MaShaoDe/RiserBoards-FT101/docs/images/README.md

# Photos

Photos for [assembly.md](../assembly.md). Licensed CC-BY-4.0. JPEG, about 1600 px wide is plenty.

| File | Shows |
|---|---|
| `01-boards-delivered.jpg` | Bare boards as delivered, top and bottom side |
| `02-connector-fitted.jpg` | Connector pushed onto the edge, side view, pins on the pads |
| `03-soldered.jpg` | Finished solder joints |
| `04-in-use.jpg` | Riser with a card in an FT-101 or FT-277 |
| `title.png` | Title image of the README (rendered from the RB18 Gerber files) |

Until the photos are added, the links in assembly.md show as missing images.
