MaShaoDe/RiserBoards-FT101/hardware/riser-2x10/preview.png

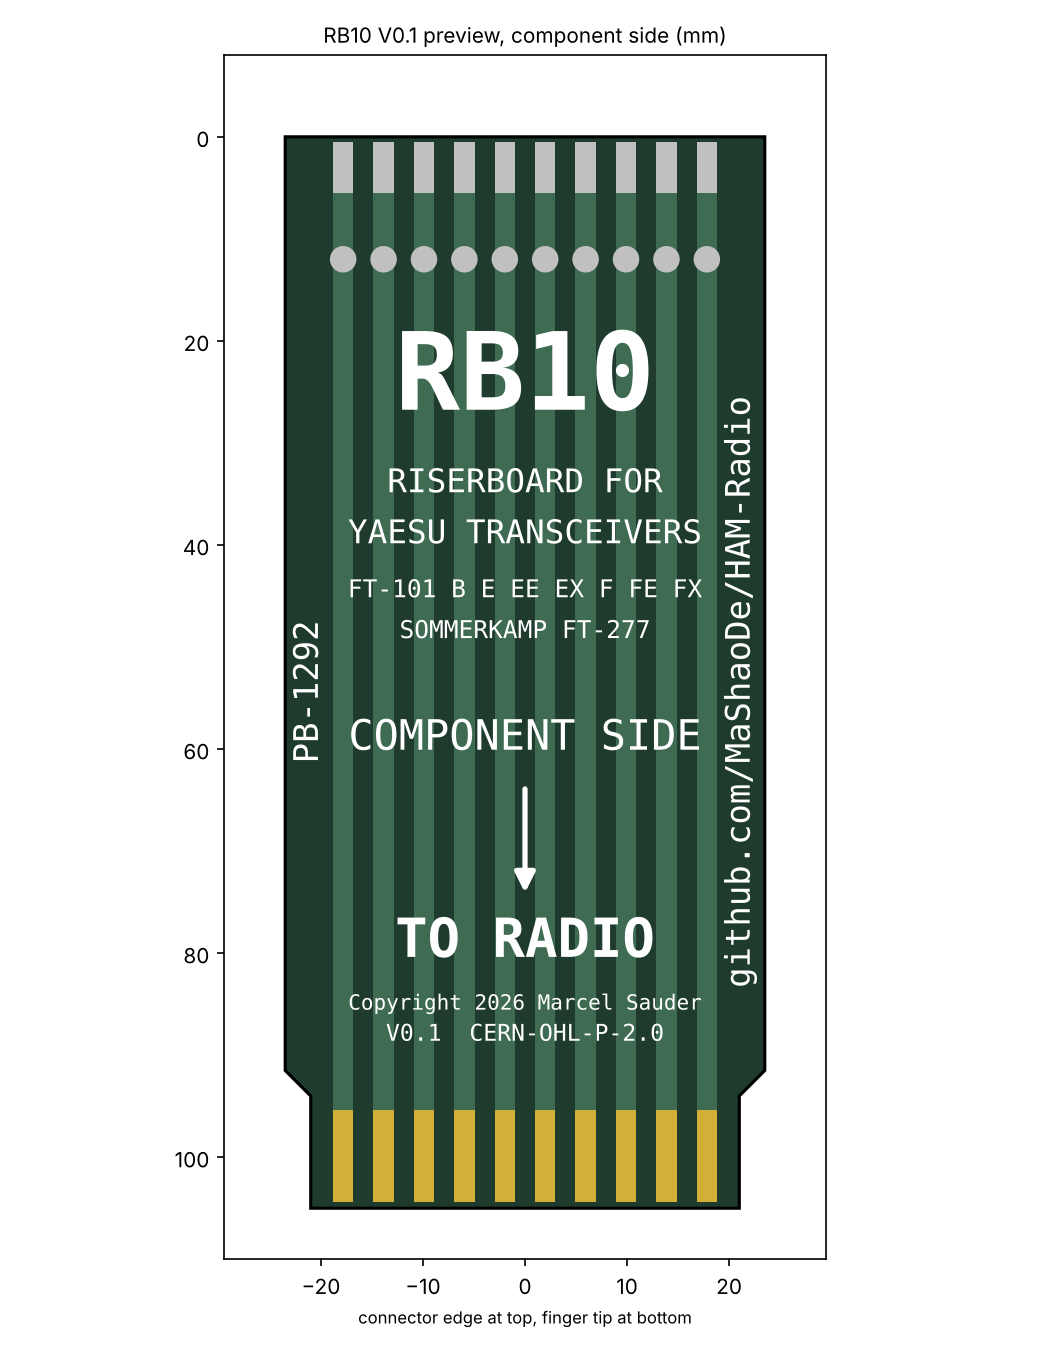
hardware/riser-2x10/preview.png
