MaShaoDe/RiserBoards-FT101/hardware/riser-2x14/preview.png

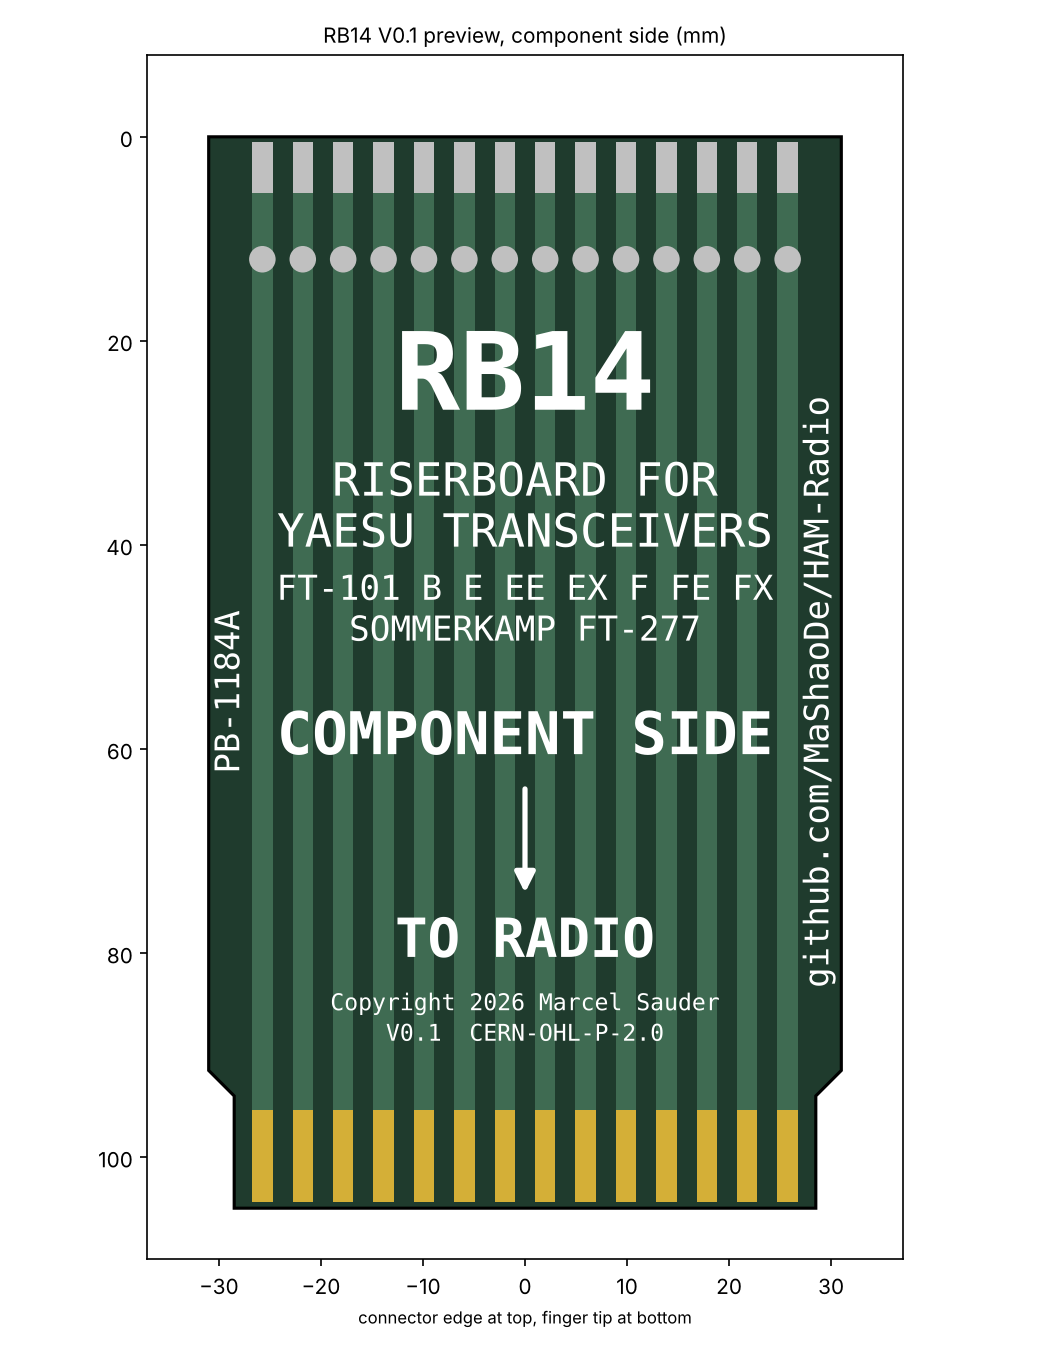
hardware/riser-2x14/preview.png
