MaShaoDe/RiserBoards-FT101/hardware/riser-2x18/preview.png

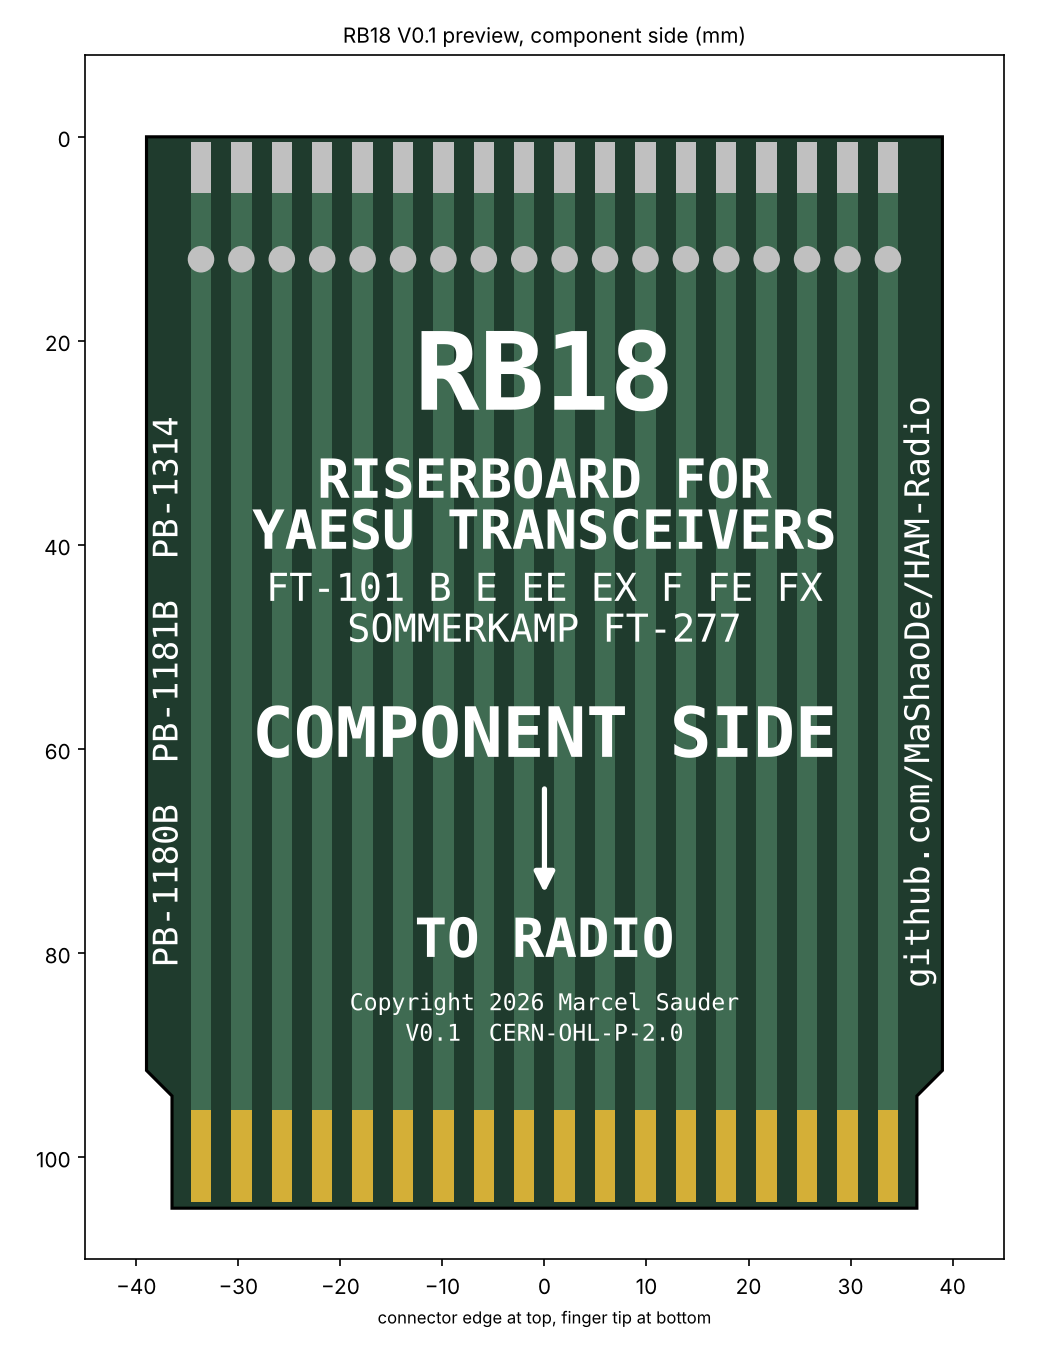
hardware/riser-2x18/preview.png
