MaShaoDe/RiserBoards-FT101/hardware/riser-2x22/preview.png

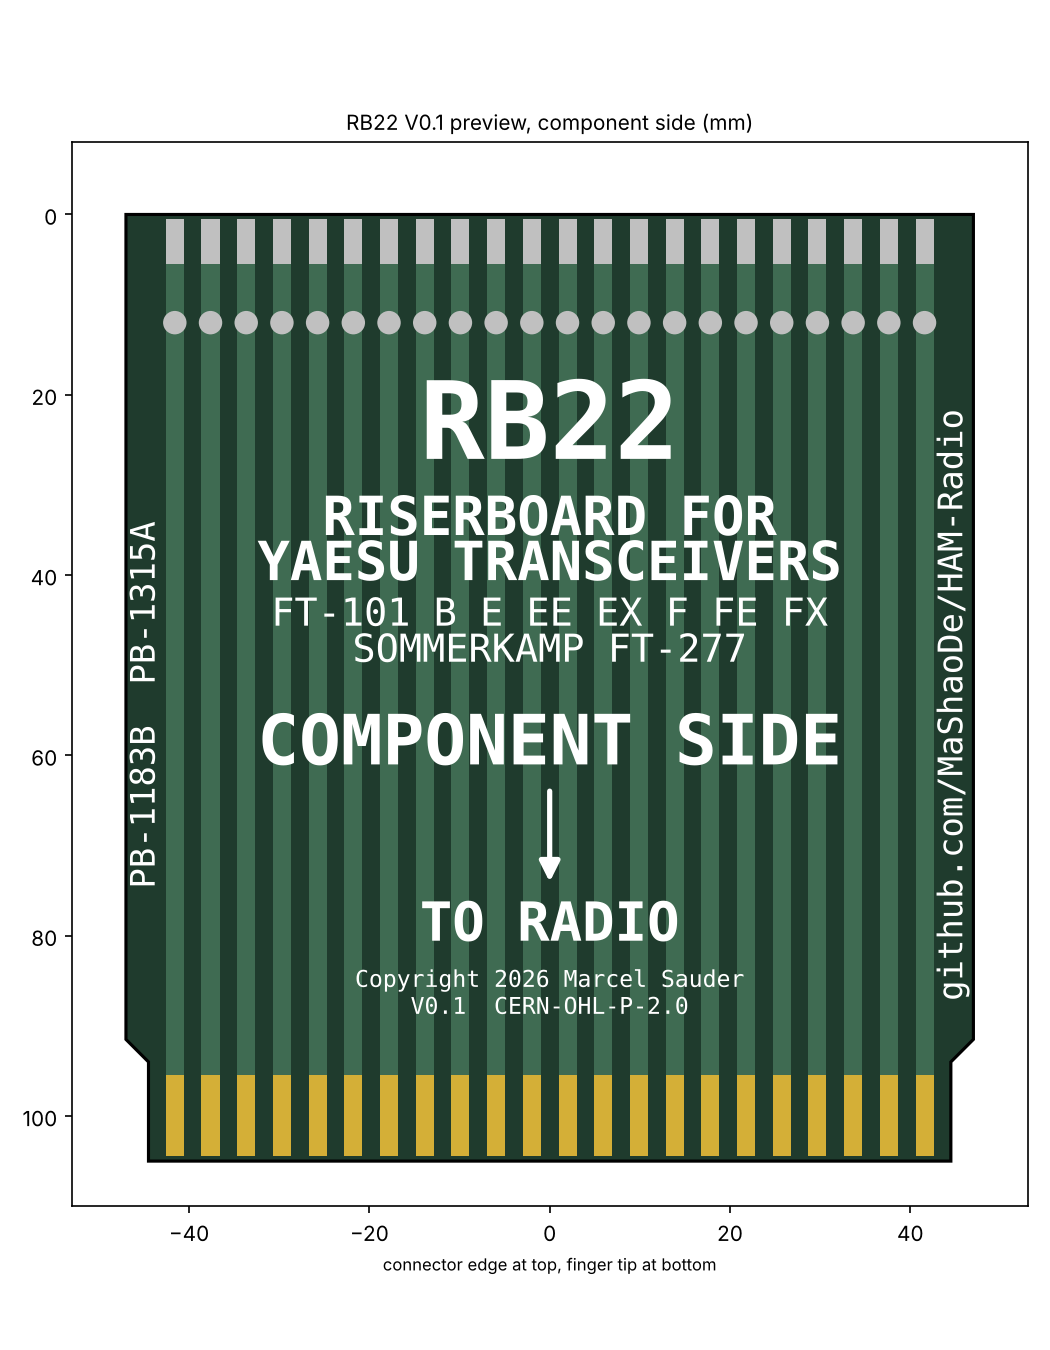
hardware/riser-2x22/preview.png
