MaShaoDe/RiserBoards-FT101/hardware/riser-2x14/riser-2x14.kicad_pcb

## KiCad design hardware/riser-2x14/riser-2x14.kicad_pcb (2026-11-12)

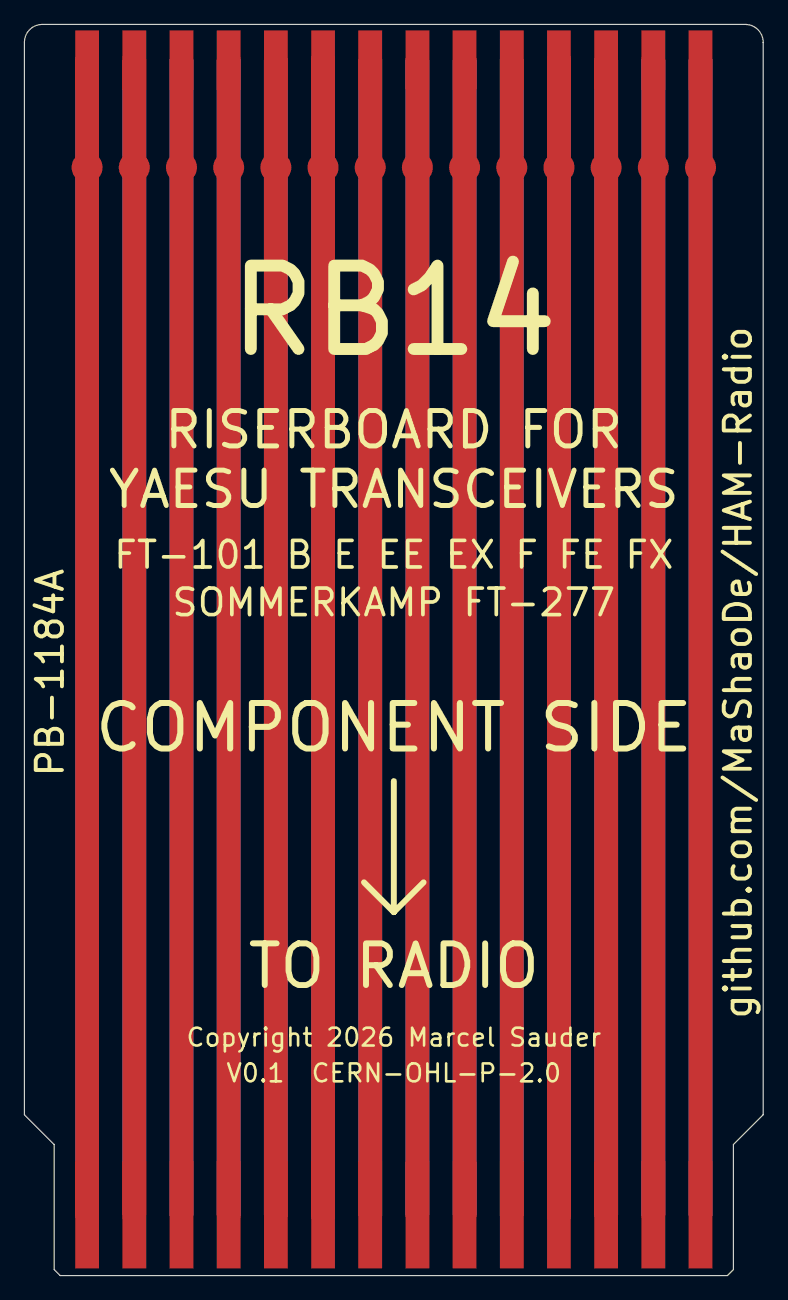
[picture p14: board riser-2x14.kicad_pcb from above]

Board: 2 copper layers, 62.0 x 105.0 mm, 3 parts (0 on the bottom side), 28 nets.

Parts:
J1: EdgeFingers_2x14
J2: ConnectorPads_2x14
TP1: TestPads_2x14

Connections:
POS01B: J1.1B, J2.1B, TP1.1B
POS01F: J1.1, J2.1, TP1.1
POS02B: J1.2B, J2.2B, TP1.2B
POS02F: J1.2, J2.2, TP1.2
POS03B: J1.3B, J2.3B, TP1.3B
POS03F: J1.3, J2.3, TP1.3
POS04B: J1.4B, J2.4B, TP1.4B
POS04F: J1.4, J2.4, TP1.4
POS05B: J1.5B, J2.5B, TP1.5B
POS05F: J1.5, J2.5, TP1.5
POS06B: J1.6B, J2.6B, TP1.6B
POS06F: J1.6, J2.6, TP1.6
POS07B: J1.7B, J2.7B, TP1.7B
POS07F: J1.7, J2.7, TP1.7
POS08B: J1.8B, J2.8B, TP1.8B
POS08F: J1.8, J2.8, TP1.8
POS09B: J1.9B, J2.9B, TP1.9B
POS09F: J1.9, J2.9, TP1.9
POS10B: J1.10B, J2.10B, TP1.10B
POS10F: J1.10, J2.10, TP1.10
POS11B: J1.11B, J2.11B, TP1.11B
POS11F: J1.11, J2.11, TP1.11
POS12B: J1.12B, J2.12B, TP1.12B
POS12F: J1.12, J2.12, TP1.12
POS13B: J1.13B, J2.13B, TP1.13B
POS13F: J1.13, J2.13, TP1.13
POS14B: J1.14B, J2.14B, TP1.14B
POS14F: J1.14, J2.14, TP1.14
