MaShaoDe/RiserBoards-FT101/(commit log)

2026-11-12 Initial import: RB riser boards for Yaesu FT-101 (moved from HAM-Radio)
    [Yaesu_riser-RB18-B_Cu.gbl, Yaesu_riser-RB18-B_Mask.gbs, Yaesu_riser-RB18-B_Silkscreen.gbo, Yaesu_riser-RB18-Edge_Cuts.gm1, Yaesu_riser-RB18-F_Cu.gtl, Yaesu_riser-RB18-F_Mask.gts, Yaesu_riser-RB18-F_Silkscreen.gto, Yaesu_riser-RB18-NPTH.drl]
2026-11-12 Prepare V0.2 silkscreen: copyright holder and repository link
