MaShaoDe/RiserBoards-FT101/(notices)

Notices in the files:
hardware/riser-2x10/riser-2x10.kicad_pcb:
V0.1 CERN-OHL-P-2.0
